GabenRulez/SmartHomeAppliance/media/photos/workLog/pinoutScreen.jpg

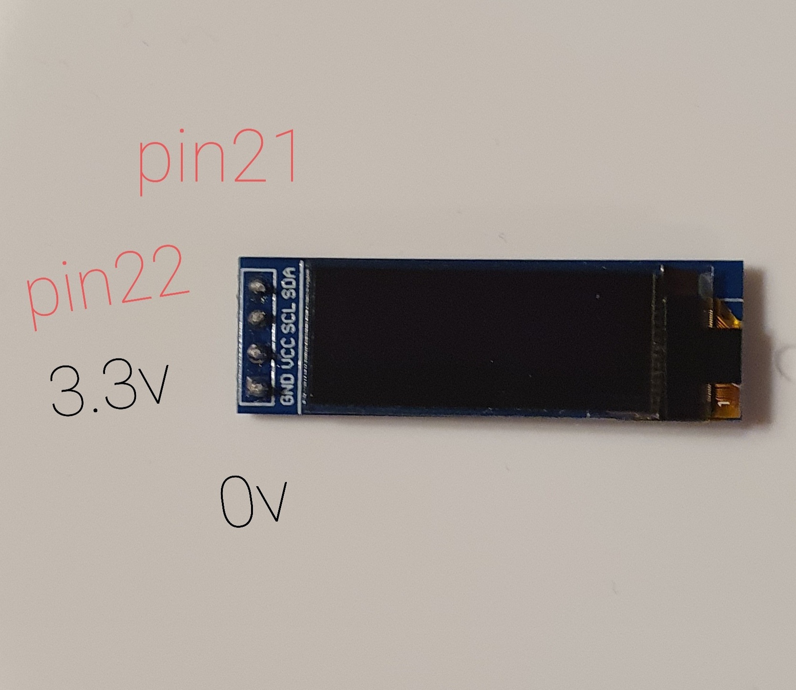
media/photos/workLog/pinoutScreen.jpg
