GabenRulez/SmartHomeAppliance/media/schematics/2021-06-11_full/circuit.png

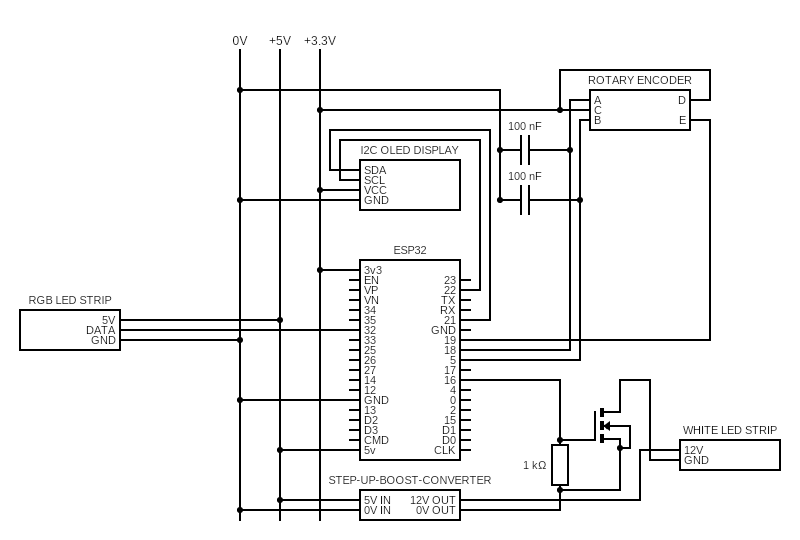
media/schematics/2021-06-11_full/circuit.png
