GabenRulez/SmartHomeAppliance/code/SmartHomeAppliance/02_OLEDScreen.ino

Adafruit_SSD1306 display(SCREEN_WIDTH, SCREEN_HEIGHT, &Wire, OLED_RESET);


void initializeScreen() {
  if (!display.begin(SSD1306_SWITCHCAPVCC, SCREEN_ADDRESS)) sendErrorToSerial("SSD1306 allocation failed");
  displayCore = xPortGetCoreID();
}


void initializeDisplay() {
  display.setTextColor(WHITE);
  display.setTextSize(1);
  display.setTextWrap(1);
  display.clearDisplay();
  display.display();
  screenControllerQueue = initializeQueue(SCREEN_QUEUE_LENGTH, sizeof( struct ScreenControllerCommand ) );
  ScreenControllerCommand screenControllerCommandTemp = {mainMenu};
  sendScreenControllerCommand(screenControllerCommandTemp);
}


void startScreenManagerTask() {
  xTaskCreatePinnedToCore( screenManagerTask, "screenManagerTask", 3000, (void*) NULL, 2, NULL, displayCore );
}


void sendScreenControllerCommand(ScreenControllerCommand command) {
  xQueueSend( screenControllerQueue, &command, ( TickType_t ) 0 );
}


void displayDefaultFrame(float multiplier) {
  uint8_t lineLength = floor(multiplier * min(SCREEN_WIDTH, SCREEN_HEIGHT) / 8.0);

  display.drawFastHLine(0,                            0,                              lineLength, WHITE);
  display.drawFastVLine(0,                            0,                              lineLength, WHITE);

  display.drawFastHLine(SCREEN_WIDTH - lineLength,    0,                              lineLength, WHITE);
  display.drawFastVLine(SCREEN_WIDTH - 1,             0,                              lineLength, WHITE);

  display.drawFastHLine(0,                            SCREEN_HEIGHT - 1,              lineLength, WHITE);
  display.drawFastVLine(0,                            SCREEN_HEIGHT - lineLength,     lineLength, WHITE);

  display.drawFastHLine(SCREEN_WIDTH - lineLength,    SCREEN_HEIGHT - 1,              lineLength, WHITE);
  display.drawFastVLine(SCREEN_WIDTH - 1,             SCREEN_HEIGHT - lineLength,     lineLength, WHITE);
}


void screenManagerTask(void *parameters) {
  portTickType screenUpdateTick = xTaskGetTickCount();
  int frameTime = 1000 / FPS;

  RotaryEncoderInputCommand rotaryEncoderInputCommand;
  ScreenControllerCommand screenControllerCommand;
  ScreenControllerCommandType currentMode = mainMenu;

  uint8_t depth = 0;

  while (true) {
    screenUpdateTick = xTaskGetTickCount();

    ScreenControllerCommand screenControllerCommand;
    LEDControllerCommand ledControllerCommand;

    while ( xQueueReceive( rotaryEncoderInputQueue, &rotaryEncoderInputCommand, (TickType_t) 0)) {
      switch (depth) {
        case 0:
          switch (rotaryEncoderInputCommand.type) {
            case buttonPress:
              screenControllerCommand = {(ScreenControllerCommandType)((currentMode + SCREEN_COMMAND_COUNT) % (2 * SCREEN_COMMAND_COUNT))};
              sendScreenControllerCommand(screenControllerCommand);
              break;

            case left:
              screenControllerCommand = {(ScreenControllerCommandType)((currentMode + SCREEN_COMMAND_COUNT - 1) % SCREEN_COMMAND_COUNT)};
              sendScreenControllerCommand(screenControllerCommand);
              break;

            case right:
              screenControllerCommand = {(ScreenControllerCommandType)((currentMode + 1) % SCREEN_COMMAND_COUNT)};
              sendScreenControllerCommand(screenControllerCommand);
              break;
          }
          break;

        case 1:
          switch (rotaryEncoderInputCommand.type) {
            case buttonPress:

              switch (currentMode) {
                case mainMenuSettings:
                  ledControllerCommand = {lightsOFF};
                  sendLEDControllerCommand(ledControllerCommand);

                  screenControllerCommand = {mainMenu};
                  sendScreenControllerCommand(screenControllerCommand);
                  break;
                  

                case warmLightsSettings:
                  ledControllerCommand = {warmLightsON, 127};
                  sendLEDControllerCommand(ledControllerCommand);

                  screenControllerCommand = {warmLights, 127};
                  sendScreenControllerCommand(screenControllerCommand);
                  break;


                case staticRGBColorSettings:
                  ledControllerCommand = {staticColor, 0, 0, 177, 27, 165};
                  sendLEDControllerCommand(ledControllerCommand);

                  screenControllerCommand = {staticRGBColor, 0, 177, 27, 165};
                  sendScreenControllerCommand(screenControllerCommand);
                  break;


                case twoColorsRGBSettings:
                  ledControllerCommand = {twoColors, 0, 127, 177, 27, 165, 52, 229, 255};
                  sendLEDControllerCommand(ledControllerCommand);

                  screenControllerCommand = {twoColorsRGB};
                  sendScreenControllerCommand(screenControllerCommand);
                  break;


                case rainbowModeSettings:
                  ledControllerCommand = {rainbow, 127, 127};
                  sendLEDControllerCommand(ledControllerCommand);

                  screenControllerCommand = {rainbowMode};
                  sendScreenControllerCommand(screenControllerCommand);
                  break;

                default:
                  break;
              }
              break;
            default:
              break;
          }
          break;
        default:
          depth = 0;
          break;
      }
    };

    if ( xQueueReceive( screenControllerQueue, &screenControllerCommand, (TickType_t) 0)) {

      currentMode = screenControllerCommand.type;

      switch (currentMode) {
        case mainMenu:
          display.clearDisplay();
          depth = 0;
          displayDefaultFrame(1);
          displayMainMenu();
          break;

        case warmLights:
          display.clearDisplay();
          depth = 0;
          displayDefaultFrame(1);
          displayWarmLights();
          break;

        case staticRGBColor:
          display.clearDisplay();
          depth = 0;
          displayDefaultFrame(1);
          displayStaticRGB();
          break;

        case twoColorsRGB:
          display.clearDisplay();
          depth = 0;
          displayDefaultFrame(1);
          displayTransitionRGB();
          break;

        case rainbowMode:
          display.clearDisplay();
          depth = 0;
          displayDefaultFrame(1);
          displayRainbowMode();
          break;

        case showIPAddress:
          display.clearDisplay();
          depth = 0;
          displayDefaultFrame(1);
          displayIPAddress();
          break;

        case mainMenuSettings:
          display.clearDisplay();
          depth = 1;
          displayMainMenuSettings();
          break;

        case warmLightsSettings:
          display.clearDisplay();
          depth = 1;
          displayWarmLightsSettings();
          break;

        case staticRGBColorSettings:
          display.clearDisplay();
          depth = 1;
          displayStaticRGBColorSettings();
          break;

        case twoColorsRGBSettings:
          display.clearDisplay();
          depth = 1;
          displayTwoColorsRGBSettings();
          break;

        case rainbowModeSettings:
          display.clearDisplay();
          depth = 1;
          displayRainbowModeSettings();
          break;

        default:
          break;
      }
      display.display();
    };
    vTaskDelayUntil( &screenUpdateTick, frameTime);
  }
  vTaskDelete(NULL);
}


void displayMainMenu() {
  display.setCursor(4, 8);
  display.setTextSize(2);
  display.print("Lights OFF");
  display.setTextSize(1);
}


void displayWarmLights() {
  display.setCursor(4, 8);
  display.setTextSize(2);
  display.print("Warm Light");
  display.setTextSize(1);
}


void displayStaticRGB() {
  display.setCursor(4, 8);
  display.setTextSize(2);
  display.print("Static RGB");
  display.setTextSize(1);
}


void displayTransitionRGB() {
  display.setCursor(10, 0);
  display.setTextSize(2);
  display.print("Two-color");
  display.setCursor(46, 16);
  display.print("RGB");
  display.setTextSize(1);
}


void displayRainbowMode() {
  display.setCursor(22, 8);
  display.setTextSize(2);
  display.print("Rainbow");
  display.setTextSize(1);
}


void displayIPAddress() {
  display.setCursor(34, 0);
  display.print("IP Address");
  display.setCursor(2, 8);
  display.println("ST: " + stringIPAddress(StationIPAddress));
  display.setCursor(2, 16);
  display.println("AP: " + stringIPAddress(AccessPointIPAddress));
}


void displayDefaultSettings() {
  display.drawRect(0, 0, SCREEN_WIDTH, SCREEN_HEIGHT, WHITE);
}


void displayMainMenuSettings() {
  displayDefaultSettings();
  display.setCursor(5, 5);
  display.println("Turn OFF");
  display.setCursor(5, 15);
  display.println("all the lights");
}


void displayWarmLightsSettings() {
  displayDefaultSettings();
  display.setCursor(5, 5);
  display.println("Turn ON");
  display.setCursor(5, 15);
  display.println("with 50% brightness");
}


void displayStaticRGBColorSettings() {
  displayDefaultSettings();
  display.setCursor(5, 5);
  display.println("Turn ON RGB LEDs");
  display.setCursor(5, 15);
  display.println("with Pink color");
}


void displayTwoColorsRGBSettings() {
  displayDefaultSettings();
  display.setCursor(5, 3);
  display.println("Turn ON RGB LEDs");
  display.setCursor(5, 12);
  display.println("to oscillate between");
  display.setCursor(5, 21);
  display.println("Pink and Blue");
}


void displayRainbowModeSettings() {
  displayDefaultSettings();
  display.setCursor(5, 3);
  display.println("Turn ON");
  display.setCursor(5, 12);
  display.println("the 'rainbow' mode");
}
