GabenRulez/SmartHomeAppliance/code/SmartHomeAppliance/SmartHomeAppliance.ino

/*
  This is a main file of our project for Embedded Systems course in AGH Kraków.
  Additional code is in multiple .ino files in the same directory.
*/

#include <SPI.h>
#include <Wire.h>
#include <Adafruit_GFX.h>
#include <Adafruit_SSD1306.h>
#include <Adafruit_NeoPixel.h>
#include <WiFi.h>
#include <AsyncTCP.h>
#include <ESPAsyncWebServer.h>


enum RotaryEncoderInputCommandType {
  buttonPress = 0,
  left = 1,
  right = 2
};


struct RotaryEncoderInputCommand {
  RotaryEncoderInputCommandType type;
};


enum ScreenControllerCommandType {
  mainMenu = 0,
  warmLights = 1,
  staticRGBColor = 2,
  twoColorsRGB = 3,
  rainbowMode = 4,
  showIPAddress = 5,

  mainMenuSettings = 6,
  warmLightsSettings = 7,
  staticRGBColorSettings = 8,
  twoColorsRGBSettings = 9,
  rainbowModeSettings = 10
};


struct ScreenControllerCommand {
  ScreenControllerCommandType type;
  uint8_t brightness;
  uint8_t red;
  uint8_t green;
  uint8_t blue;
};


enum LEDControllerCommandType {
  lightsOFF = 0,
  warmLightsON = 1,
  staticColor = 2,
  twoColors = 3,
  rainbow = 5
};


struct LEDControllerCommand {
  LEDControllerCommandType type;
  uint8_t brightness;
  uint8_t animationIntervalMultiplier;
  uint8_t red1;
  uint8_t green1;
  uint8_t blue1;
  uint8_t red2;
  uint8_t green2;
  uint8_t blue2;
  uint8_t red3;
  uint8_t green3;
  uint8_t blue3;
};


#include "config.h"
#include "secretConfig.h"
#include "website.h"
