GabenRulez/SmartHomeAppliance/(commit log)

2021-03-25 Added the exact copy of drivers for CP2102 USB to UART Bridge.
2021-04-12 Added rotary encoder support (with debounce functionality)
    I had a lot of problems debugging this rotary encoder.
    Turns out, ESP32 is "too fast" and interrupts triggered by `RISING` were triggered ~15-20 times per the smallest rotation of the encoder (checked this with oscilloscope).
    Implemented debounce function (by using FreeRTOS) to minimize "fake" inputs (now
    the counter increases by 1, or by 2 (when you forcibly hold it in the wrong position)).
    [SmartHomeAppliance.ino]
2021-04-13 Multiple changes + refactoring. Main: Updating the screen is now taken care of in task, rather than `loop()` function.
    - `random` now takes seed from `DISCONNECTED_PIN`
    - I^2C operations have to be performed on the same core (no switching), so after first I^2C operation, the core number is saved in `displayCore`
    - Added `sendErrorToSerial` function to cleanup the code
    - Added `initializeMutex` function
    - Fixed a lot of bugs with rotary encoder (due to multithreading on ESP32).
    [SmartHomeAppliance.ino]
2021-04-13 Added capacitor photo to Readme.
2021-04-15 Added button functionality (by polling).
    Button is a part of 5-pin rotary encoder.
2021-04-15 Code cleanup. `initializeSemaphore` now returns said semaphore.
    + OLED display now shows, whether the button is currently pressed.
2021-04-15 Deleted unimportant `Serial.println`.
2021-04-22 Updated Readme.md. Added libraries list. Added Mosfet picture.
2021-04-29 Added indicator, that states whether the ESP32 server is reachable or not.
2021-04-29 Added "modes" functionality. Added buttons on the website to change these modes.
2021-05-12 Added control for RGB LEDs (needs improvements, but works).
2021-05-13 Added LED controller task, which receives commands by queue and manages LED strips.
2021-05-14 Added LED Controller task. Switched all LED based functions to him.
2021-05-15 Added `warmLights` functionality to `PWM` controlled `12V` LED strip.
2021-05-20 Fixed brightness control for `rainbow` mode.
    [05_LEDController.ino, config.h]
2021-05-26 ESP32 webserver now serves the minified HTML file on `/` path.
2021-05-26 Rotary encoder now sends `RotaryEncoderInputCommand`s to the `Queue`, and then the OLED screen task takes care of it.
    Creates much less delays in the program. Got rid of semaphores, as they are no longer required.
    [02_OLEDScreen.ino, 03_RotaryEncoder.ino, 05_LEDController.ino, SmartHomeAppliance.ino, config.h]
2021-05-26 Cleanup + little bugfix.
    [01_DeviceFunctions.ino, 02_OLEDScreen.ino, 03_RotaryEncoder.ino, 04_WiFiServer.ino, 05_LEDController.ino, SmartHomeAppliance.ino, _Main.ino, config.h]
2021-06-20 Added circuit schematics (final).
